CircuitCo/BeagleBone-DVI-D/(list of files, drawings)

Other design files:
BeagleBone-DVI-D-01-schematic.dsn
BeagleBone-DVI-D-RevA-schematic.dsn
